Alexandr-Filatov/Three-Phase-80kWt/3D models/K78xxM-1000R3.stp

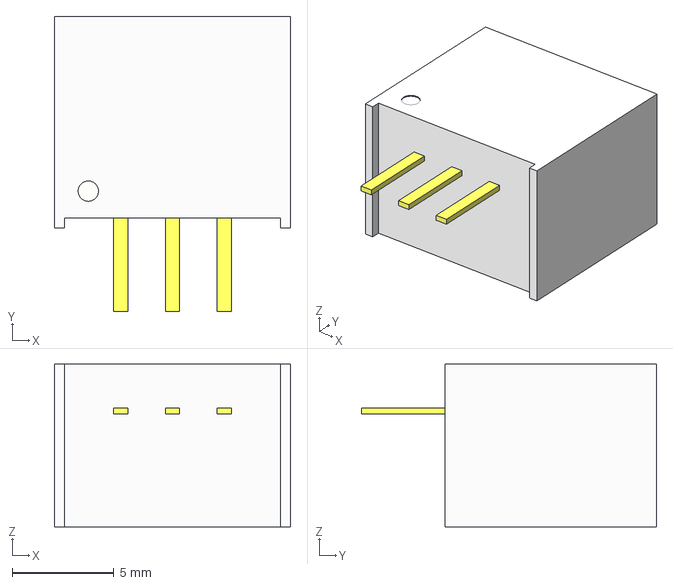
[picture p1: CAD file, 2024-10-06]
3D models/K78xxM-1000R3.stp
11.6 x 14.5 x 8.00 mm
