Alexandr-Filatov/Three-Phase-80kWt/3D models/Adapter.step

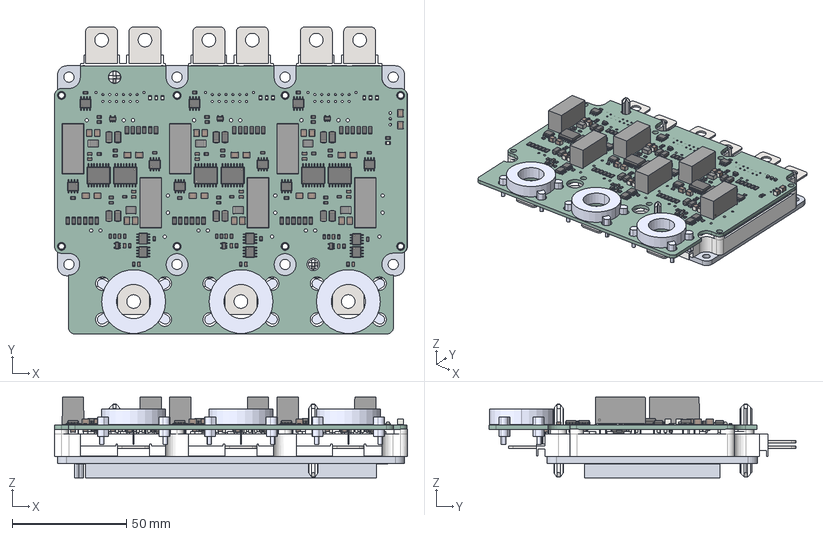
[picture p2: CAD file, 2024-10-06]
3D models/Adapter.step
154.6 x 134.5 x 35.2 mm
R_0805_2012Metric x 67
SOT_23_5 x 6
Current sensor low x 3
D_SMA x 12
C_1210_3225Metric x 26
R_1206_3216Metric x 36
C_0805_2012Metric x 63
WR_S-1WR2_ASM x 6
SOIC_8_39x49mm_P127mm x 15
LED_0805_2012Metric x 10
SOIC_16W_75x103mm_P127mm x 6
L_1812_4532Metric x 6
Starpower GD820HTX75P6HB
D_SOD_123 x 6
SOT_223 x 3
Adapter_PCB
