Alexandr-Filatov/Three-Phase-80kWt/3D models/Starpower GD820HTX75P6HB.STEP

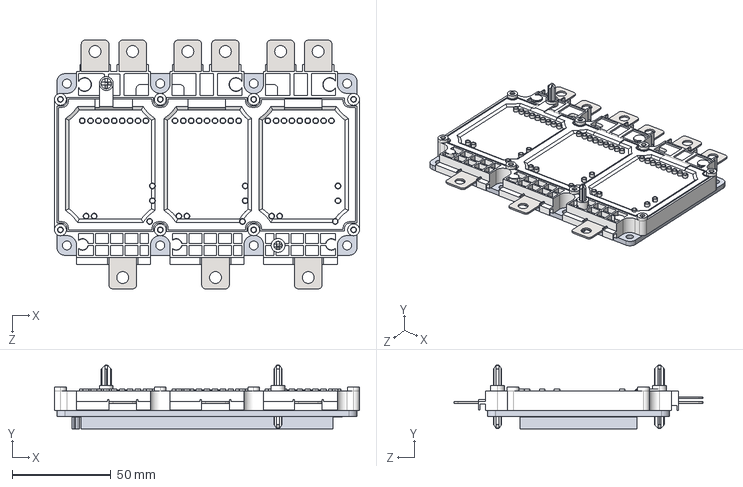
[picture p3: CAD file, 2024-10-06]
3D models/Starpower GD820HTX75P6HB.STEP
154.5 x 32.3 x 126.0 mm
