Alexandr-Filatov/Three-Phase-80kWt/3D models/K78xx-1000R3.stp

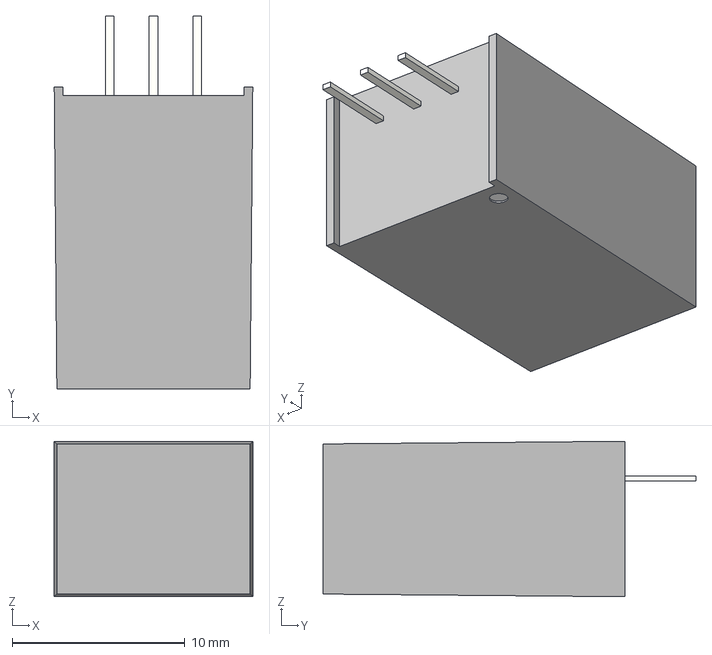
[picture p4: CAD file, 2024-09-23]
3D models/K78xx-1000R3.stp
11.5 x 21.6 x 9.00 mm
K78-1000_1
PRT0001_1 x 3
