Alexandr-Filatov/Three-Phase-80kWt/3D models/Current sensor low.STEP

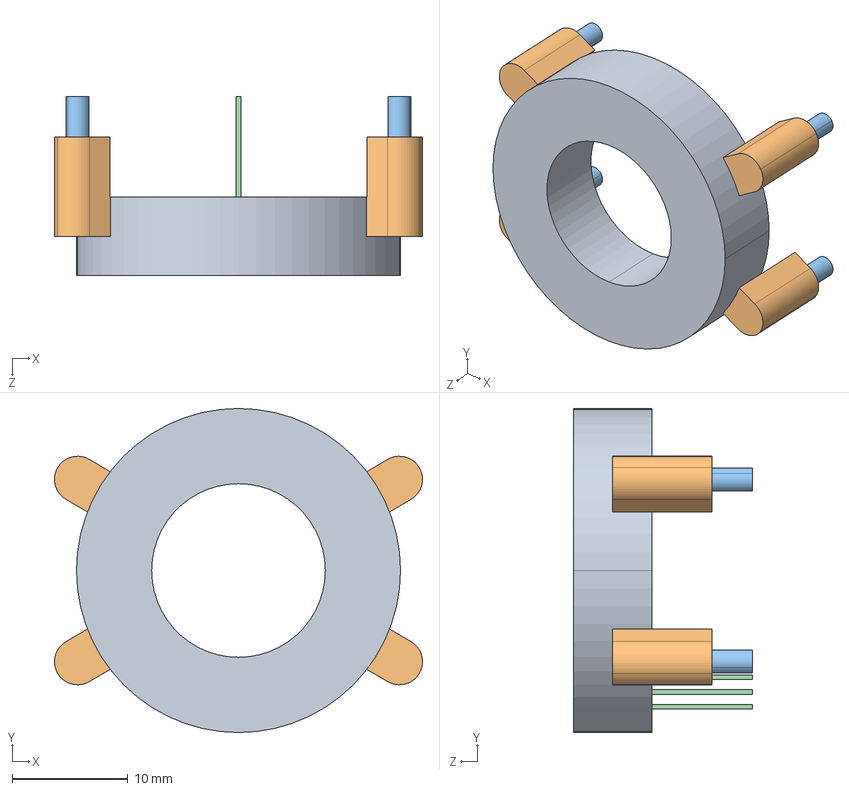
[picture p5: CAD file, 2024-09-12]
3D models/Current sensor low.STEP
31.8 x 28.0 x 15.5 mm
