Alexandr-Filatov/Three-Phase-80kWt/3D models/Current sensor.STEP

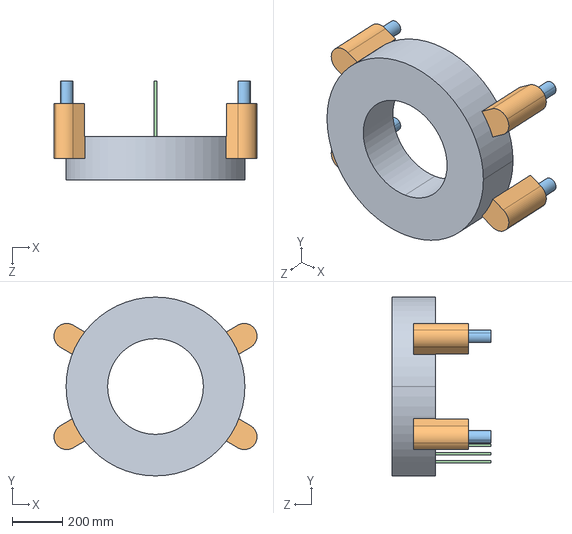
[picture p6: CAD file, 2024-09-12]
3D models/Current sensor.STEP
807.6 x 711.2 x 393.7 mm
