Alexandr-Filatov/Three-Phase-80kWt/3D models/WRA_S-3WR2.stp

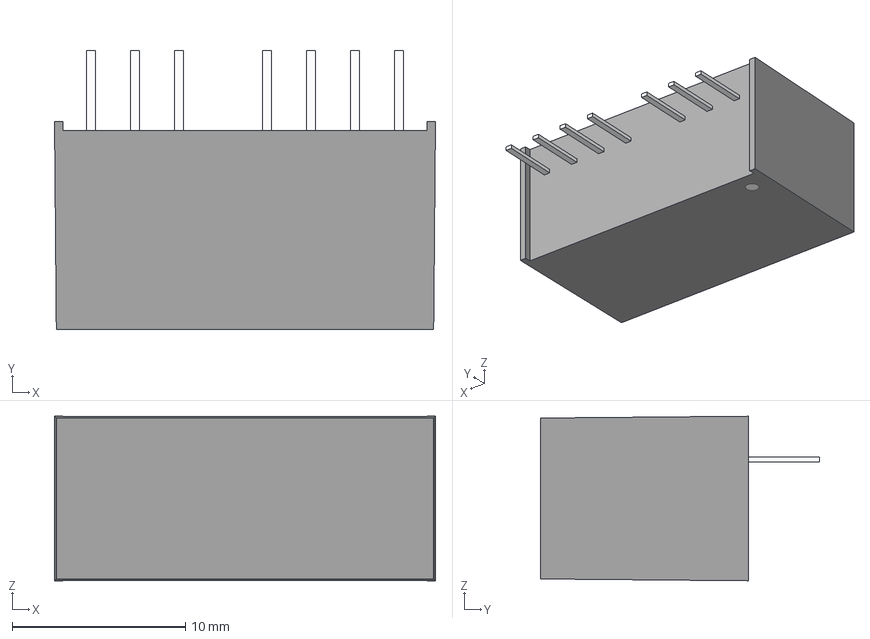
[picture p7: CAD file, 2024-09-02]
3D models/WRA_S-3WR2.stp
22.0 x 16.1 x 9.50 mm
PIN_3_1_1_1 x 7
