Alexandr-Filatov/Three-Phase-80kWt/3D models/URA_ZP-6WR3.stp

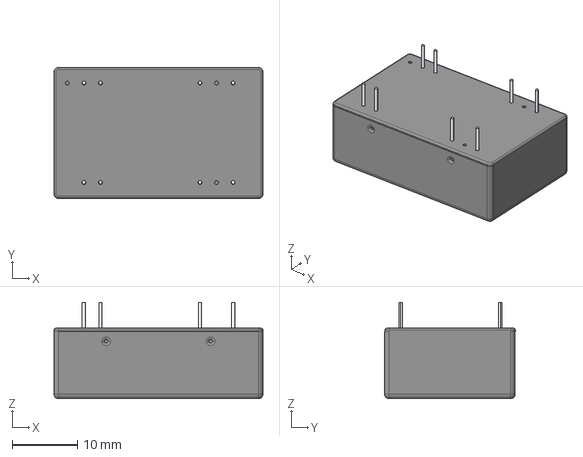
[picture p8: CAD file, 2024-09-02]
3D models/URA_ZP-6WR3.stp
32.0 x 20.1 x 14.8 mm
