Alexandr-Filatov/Three-Phase-80kWt/3D models/430251210.stp

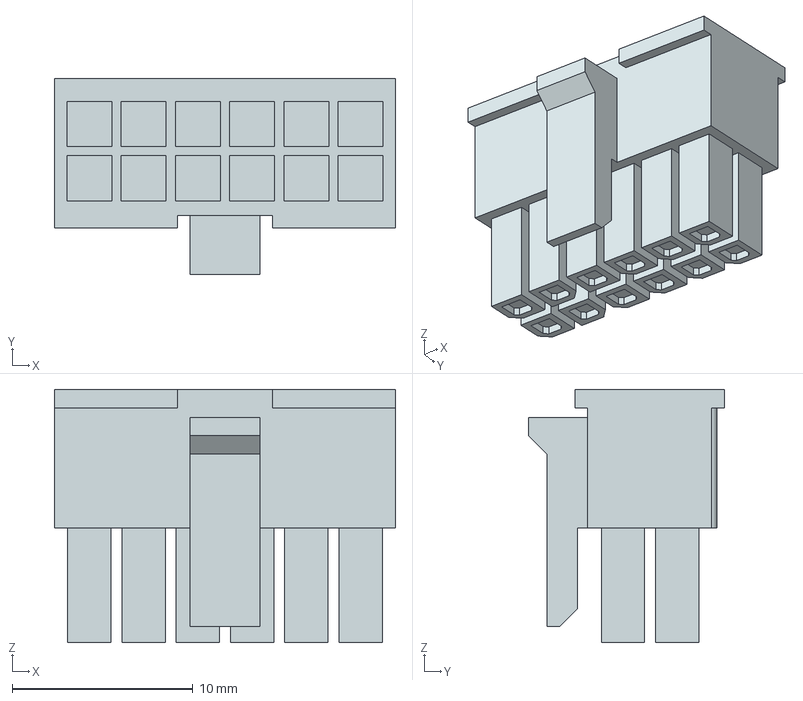
[picture p9: CAD file, 2024-11-12]
3D models/430251210.stp
18.9 x 10.8 x 14.0 mm
