Alexandr-Filatov/Three-Phase-80kWt/3D models/430451212.stp

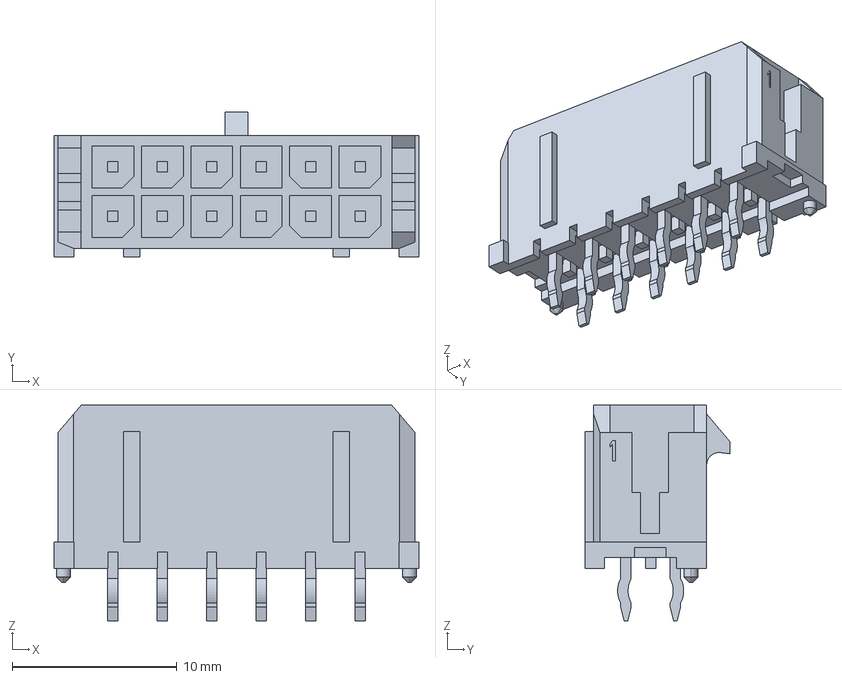
[picture p10: CAD file, 2024-09-26]
3D models/430451212.stp
22.1 x 8.77 x 13.1 mm
