Alexandr-Filatov/Three-Phase-80kWt/3D models/2068321222.stp

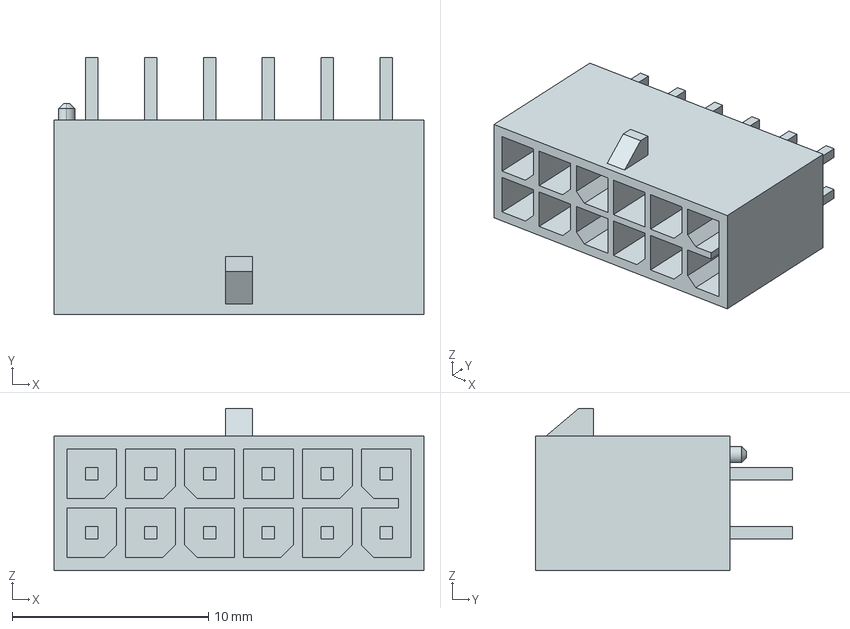
[picture p11: CAD file, 2024-09-26]
3D models/2068321222.stp
18.9 x 13.1 x 8.26 mm
