Alexandr-Filatov/Three-Phase-80kWt/(list of files, drawings)

Other design files:
K78xx-1000R3.SchLib
K78xxM-1000R3 正输出.SchLib
K78xxM-1000R3 负输出.PcbLib
K78xxM-1000R3 负输出.SchLib
K78xxM-1000R3.PcbLib
URA_ZP-6WR3.PcbLib
WRA_S-3WR2.PcbLib
