Alexandr-Filatov/Three-Phase-80kWt/Adapter.kicad_pcb

## KiCad design Adapter.kicad_pcb (2024-11-13)

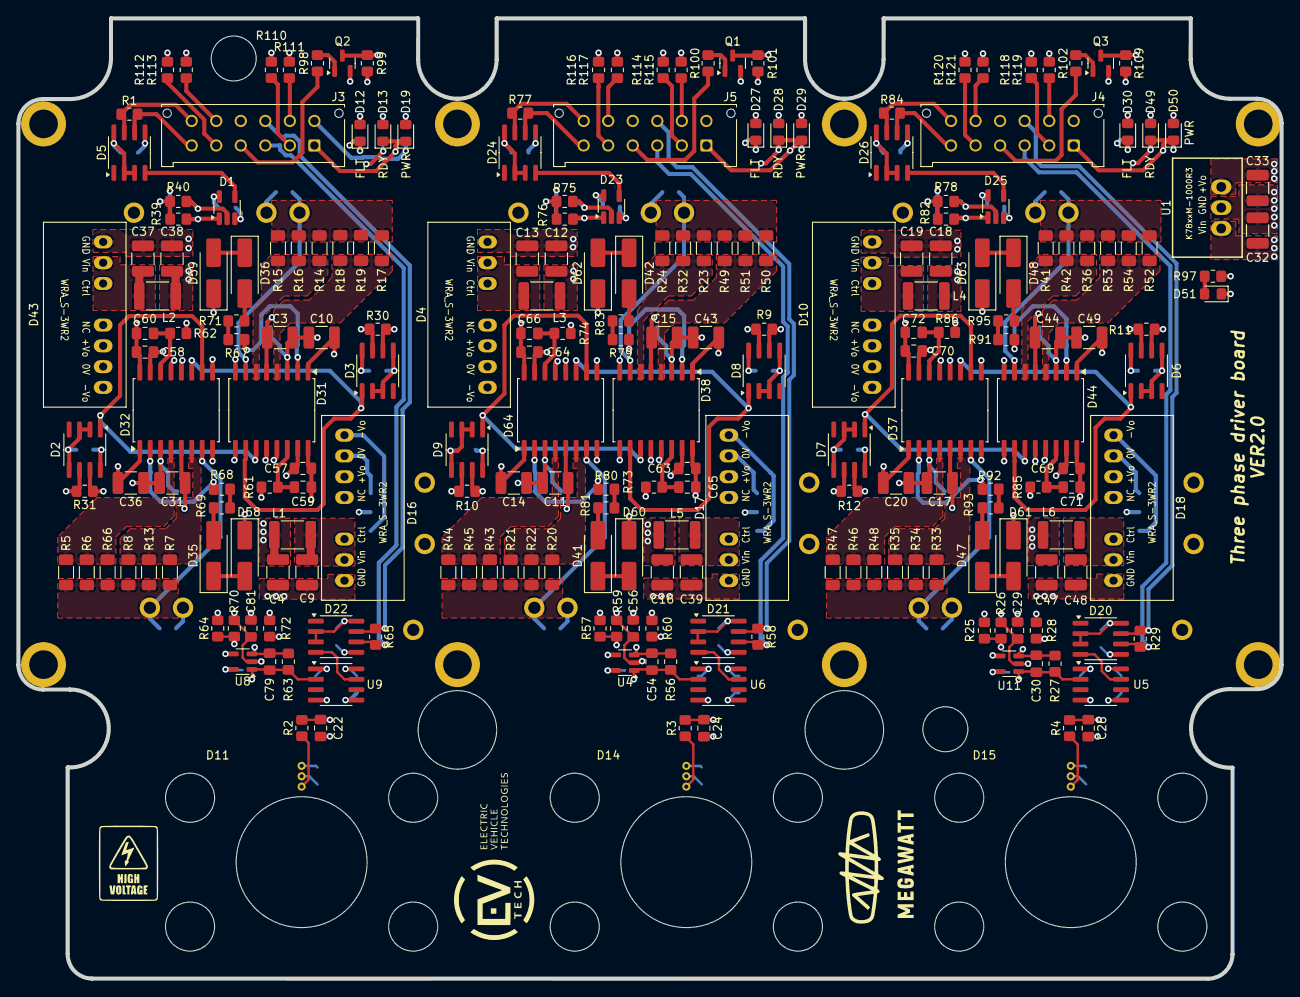
[picture p12: board Adapter.kicad_pcb from above]

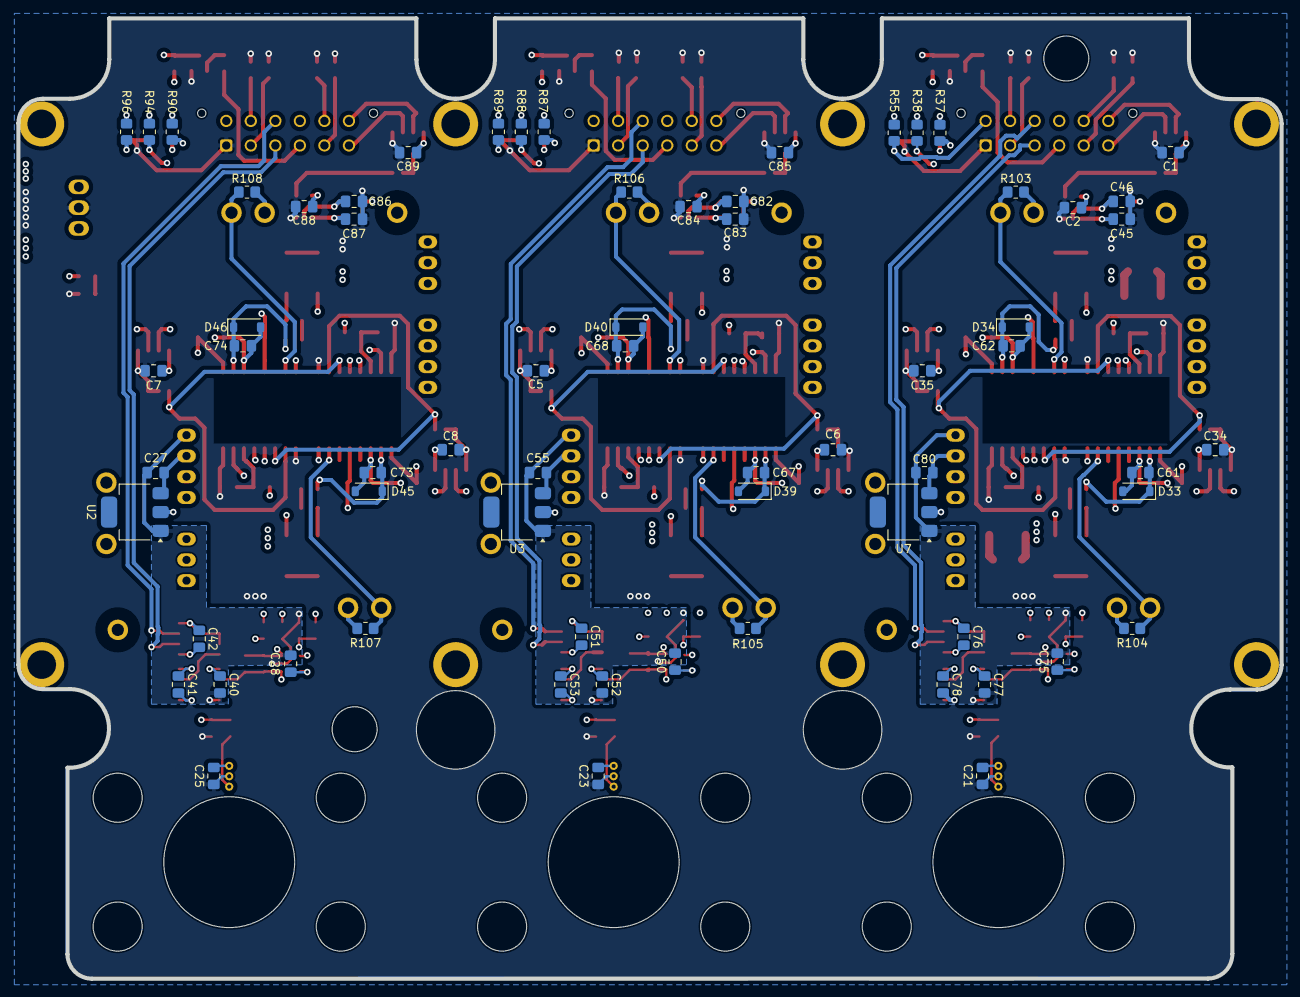
[picture p13: board Adapter.kicad_pcb from below]

Board: 6 copper layers, 154.4 x 117.4 mm, 291 parts (66 on the bottom side), 161 nets.

Parts:
C1, C2, C5, C6, C7, C8, C27, C28, C34, C35, C40, C41, C42, C50, C51, C52, C53, C55, C75, C76, C77, C78, C80, C84, C85, C88, C89: 2.2u; C_0805_2012Metric_Pad1.18x1.45mm_HandSolder
C3, C4, C9, C10, C11, C12, C13, C14, C15, C16, C17, C18, C19, C20, C31, C32, C36, C37, C38, C39, C43, C44, C47, C48, C49: 10u; C_1210_3225Metric_Pad1.33x2.70mm_HandSolder
C21, C23, C25, C57, C58, C63, C64, C69, C70: 0.1u; C_0805_2012Metric_Pad1.18x1.45mm_HandSolder
C22, C24, C26: 10u; C_0805_2012Metric_Pad1.18x1.45mm_HandSolder
C29, C56, C81: 10n; C_0805_2012Metric_Pad1.18x1.45mm_HandSolder
C30, C45, C46, C54, C59, C60, C65, C66, C71, C72, C79, C82, C83, C86, C87: 56p; C_0805_2012Metric_Pad1.18x1.45mm_HandSolder
C33: 22u; C_1210_3225Metric_Pad1.33x2.70mm_HandSolder
C61, C62, C67, C68, C73, C74: 220p; C_0805_2012Metric_Pad1.18x1.45mm_HandSolder
D1, D23, D25: SN74AHC1G08DBVR; SOT-23-5_HandSoldering
D2, D3, D5, D6, D7, D8, D9, D20, D21, D22, D24, D26: ADM3485E; SOIC-8_3.9x4.9mm_P1.27mm
D4, D10, D16, D17, D18, D43: WRA1215S-3WR2; WRA_S-3WR2
D11, D14, D15: YMC15S-500A
D12, D27, D30: FLT; LED_0805_2012Metric_Pad1.15x1.40mm_HandSolder
D13, D28, D49: RDY; LED_0805_2012Metric_Pad1.15x1.40mm_HandSolder
D19, D29, D50: PWR; LED_0805_2012Metric_Pad1.15x1.40mm_HandSolder
D31, D32, D37, D38, D44, D64: NSI6651ASC-DSWR; SOIC-16W_7.5x10.3mm_P1.27mm
D33, D34, D39, D40, D45, D46: MMSZ5240B; D_SOD-123
D35, D36, D41, D42, D47, D48, D58, D59, D60, D61, D62, D63: MURS160; D_SMA_Handsoldering
D51: +5V; LED_0805_2012Metric_Pad1.15x1.40mm_HandSolder
J1: GD820HTX75P6HB
J3: Control_A; Molex_Micro-Fit_3.0_43045-1212_2x06_P3.00mm_Vertical
J4: Control_C; Molex_Micro-Fit_3.0_43045-1212_2x06_P3.00mm_Vertical
J5: Control_B; Molex_Micro-Fit_3.0_43045-1212_2x06_P3.00mm_Vertical
L1, L2, L3, L4, L5, L6: 4.7u; L_1812_4532Metric_Pad1.30x3.40mm_HandSolder
Q1, Q2, Q3: BC817; SOT-23
R1, R9, R10, R11, R12, R29, R30, R31, R58, R61, R62, R65, R73, R74, R77, R84, R85, R86: 120; R_0805_2012Metric_Pad1.20x1.40mm_HandSolder
R2, R3, R4, R69, R71, R81, R83, R93, R95: 0; R_0805_2012Metric_Pad1.20x1.40mm_HandSolder
R5, R6, R7, R8, R13, R14, R15, R16, R17, R18, R19, R20, R21, R22, R23, R24, R32, R33, R34, R35, R36, R41, R42, R43, R44, R45, R46, R47, R48, R49, R50, R51, R52, R53, R54, R66: 10; R_1206_3216Metric_Pad1.30x1.75mm_HandSolder
R25, R26, R27, R56, R57, R59, R63, R64, R70, R103, R104, R105, R106, R107, R108: 10k; R_0805_2012Metric_Pad1.20x1.40mm_HandSolder
R28, R60, R72: 2.2k; R_0805_2012Metric_Pad1.20x1.40mm_HandSolder
R37, R38, R39, R40, R75, R76, R78, R82, R87, R88, R90, R94, R97, R99, R101, R109: 1k; R_0805_2012Metric_Pad1.20x1.40mm_HandSolder
R55, R89, R96: 3k; R_0805_2012Metric_Pad1.20x1.40mm_HandSolder
R67, R68, R79, R80, R91, R92: 1.1k; R_0805_2012Metric_Pad1.20x1.40mm_HandSolder
R98, R100, R102: 4.7k; R_0805_2012Metric_Pad1.20x1.40mm_HandSolder
R110, R111, R112, R113, R114, R115, R116, R117, R118, R119, R120, R121: 560; R_0805_2012Metric_Pad1.20x1.40mm_HandSolder
U1: K7805M-1000R3; K78xxM-1000R3
U2, U3, U7: LM1117GS-5.0; SOT-223
U4, U8, U11: LMV7219M5X/NOPB; SOT-23-5
U5, U6, U9: ADuM1200AR; SOIC-8_3.9x4.9mm_P1.27mm

Connections:
+5V: C1.1, C2.1, C5.1, C6.1, C7.1, C8.1, C21.1, C23.1, C25.1, C33.1, C34.1, C35.1, C41.1, C42.1, C51.1, C53.1, C57.2, C58.2, C63.2, C64.2, C69.2, C70.2, C76.1, C78.1, C84.1, C85.1, C88.1, C89.1, D1.5 (Vcc), D2.8 (VCC), D3.8 (VCC), D5.2 (RE), D5.3 (DE), D5.8 (VCC), D6.8 (VCC), D7.8 (VCC), D8.8 (VCC), D9.8 (VCC), D11.1 (+Vcc), D14.1 (+Vcc), D15.1 (+Vcc), D20.2 (RE), D20.3 (DE), D20.8 (VCC), D21.2 (RE), D21.3 (DE), D21.8 (VCC), D22.2 (RE), D22.3 (DE), D22.8 (VCC), D23.5 (Vcc), D24.2 (RE), D24.3 (DE), D24.8 (VCC), D25.5 (Vcc), D26.2 (RE), D26.3 (DE), D26.8 (VCC), D31.15 (Vcc1), D32.15 (Vcc1), D37.15 (Vcc1), D38.15 (Vcc1), D44.15 (Vcc1), D64.15 (Vcc1), R37.2, R39.2, R40.2, R75.2, R76.2, R78.2, R82.2, R87.2, R90.2, R97.2, R99.2, R101.2, R109.2, R111.2, R113.2, R115.2, R117.2, R119.2, R121.2, U1.3 (+Vo), U5.8 (VDD2), U6.8 (VDD2), U9.8 (VDD2)
+5V_A: C75.1, C77.1, R64.2, U7.2 (VO), U8.5 (V+), U9.1 (VDD1)
+5V_B: C50.1, C52.1, R57.2, U3.2 (VO), U4.5 (V+), U6.1 (VDD1)
+5V_C: C28.1, C40.1, R25.2, U2.2 (VO), U5.1 (VDD1), U11.5 (V+)
+15V: C4.1, C12.1, C16.1, C18.1, C32.1, C38.1, C47.1, J3.7, J4.7, J5.7, L1.1, L2.1, L3.1, L4.1, L5.1, L6.1, R55.2, R89.2, R96.2, U1.1 (Vin)
+15V_H1: C31.1, D32.5 (Vcc2), D43.6 (+Vo)
+15V_H2: C11.1, D4.6 (+Vo), D64.5 (Vcc2)
+15V_H3: C17.1, D10.6 (+Vo), D37.5 (Vcc2)
+15V_L1: C3.1, D16.6 (+Vo), D31.5 (Vcc2)
+15V_L2: C15.1, D17.6 (+Vo), D38.5 (Vcc2)
+15V_L3: C44.1, D18.6 (+Vo), D44.5 (Vcc2)
-15V_H1: C36.2, D32.1 (Vee2), D32.8 (Vee2), D43.8 (-Vo)
-15V_H2: C14.2, D4.8 (-Vo), D64.1 (Vee2), D64.8 (Vee2)
-15V_H3: C20.2, D10.8 (-Vo), D37.1 (Vee2), D37.8 (Vee2)
-15V_L1: C10.2, C75.2, C77.2, C80.2, C81.2, D16.8 (-Vo), D31.1 (Vee2), D31.8 (Vee2), R70.1, U7.1 (GND), U8.2 (V-), U9.4 (GND1)
-15V_L2: C43.2, C50.2, C52.2, C55.2, C56.2, D17.8 (-Vo), D38.1 (Vee2), D38.8 (Vee2), R59.1, U3.1 (GND), U4.2 (V-), U6.4 (GND1)
-15V_L3: C27.2, C28.2, C29.2, C40.2, C49.2, D18.8 (-Vo), D44.1 (Vee2), D44.8 (Vee2), R26.1, U2.1 (GND), U5.4 (GND1), U11.2 (V-)
C1: D58.1 (K), J1.1
C2: D59.1 (K), J1.2
C3: D60.1 (K), J1.9
C4: D62.1 (K), J1.10
C5: D61.1 (K), J1.17
C6: D63.1 (K), J1.18
Current_A_out: C22.1, J3.10, R2.2
Current_B_out: C24.1, J5.10, R3.2
Current_C_out: C26.1, J4.10, R4.2
E1: C31.2, C36.1, C61.2, D32.3 (GND2), D33.2 (A), D43.7 (0V), J1.3, R104.1
E2: C3.2, C10.1, C62.2, C80.1, D16.7 (0V), D31.3 (GND2), D34.2 (A), J1.4, R103.1, U7.3 (VI)
E3: C11.2, C14.1, C67.2, D4.7 (0V), D39.2 (A), D64.3 (GND2), J1.11, R105.1
E4: C15.2, C43.1, C55.1, C68.2, D17.7 (0V), D38.3 (GND2), D40.2 (A), J1.12, R106.1, U3.3 (VI)
E5: C17.2, C20.1, C73.2, D10.7 (0V), D37.3 (GND2), D45.2 (A), J1.19, R107.1
E6: C27.1, C44.2, C49.1, C74.2, D18.7 (0V), D44.3 (GND2), D46.2 (A), J1.20, R108.1, U2.3 (VI)
ERR_A_N: D5.7 (B), J3.12, R1.1
ERR_A_P: D5.6 (A), J3.6, R1.2
ERR_B_N: D24.7 (B), J5.12, R77.1
ERR_B_P: D24.6 (A), J5.6, R77.2
ERR_C_N: D26.7 (B), J4.12, R84.1
ERR_C_P: D26.6 (A), J4.6, R84.2
FLT_A: C45.1, D1.1 (B), D12.1 (K), D31.13 (~FLT), D32.13 (~FLT), R39.1
FLT_B: C83.1, D23.1 (B), D27.1 (K), D38.13 (~FLT), D64.13 (~FLT), R76.1
FLT_C: C87.1, D25.1 (B), D30.1 (K), D37.13 (~FLT), D44.13 (~FLT), R82.1
G1: D32.7 (CLAMP), J1.5, R5.1, R6.1, R7.2, R8.2, R13.2, R66.1, R104.2
G2: D31.7 (CLAMP), J1.6, R14.2, R15.2, R16.2, R17.1, R18.1, R19.1, R103.2
G3: D64.7 (CLAMP), J1.13, R20.2, R21.2, R22.2, R43.1, R44.1, R45.1, R105.2
G4: D38.7 (CLAMP), J1.14, R23.2, R24.2, R32.2, R49.1, R50.1, R51.1, R106.2
G5: D37.7 (CLAMP), J1.21, R33.2, R34.2, R35.2, R46.1, R47.1, R48.1, R107.2
G6: D44.7 (CLAMP), J1.22, R36.2, R41.2, R42.2, R52.1, R53.1, R54.1, R108.2
GND: C1.2, C2.2, C4.2, C5.2, C6.2, C7.2, C8.2, C9.2, C12.2, C13.2, C16.2, C18.2, C19.2, C21.2, C22.2, C23.2, C24.2, C25.2, C26.2, C32.2, C33.2, C34.2, C35.2, C37.2, C38.2, C39.2, C41.2, C42.2, C45.2, C46.2, C47.2, C48.2, C51.2, C53.2, C57.1, C58.1, C59.1, C60.1, C63.1, C64.1, C65.1, C66.1, C69.1, C70.1, C71.1, C72.1, C76.2, C78.2, C82.2, C83.2, C84.2, C85.2, C86.2, C87.2, C88.2, C89.2, D1.3 (GND), D2.2 (RE), D2.3 (DE), D2.5 (GND), D3.2 (RE), D3.3 (DE), D3.5 (GND), D4.1 (GND), D5.5 (GND), D6.2 (RE), D6.3 (DE), D6.5 (GND), D7.2 (RE), D7.3 (DE), D7.5 (GND), D8.2 (RE), D8.3 (DE), D8.5 (GND), D9.2 (RE), D9.3 (DE), D9.5 (GND), D10.1 (GND), D11.2 (0V), D13.1 (K), D14.2 (0V), D15.2 (0V), D16.1 (GND), D17.1 (GND), D18.1 (GND), D19.1 (K), D20.5 (GND), D21.5 (GND), D22.5 (GND), D23.3 (GND), D24.5 (GND), D25.3 (GND), D26.5 (GND), D28.1 (K), D29.1 (K), D31.9 (GND1), D31.16 (TEST), D32.9 (GND1), D32.16 (TEST), D37.9 (GND1), D37.16 (TEST), D38.9 (GND1), D38.16 (TEST), D43.1 (GND), D44.9 (GND1), D44.16 (TEST), D49.1 (K), D50.1 (K), D51.1 (K), D64.9 (GND1), D64.16 (TEST), J3.1, J4.1, J5.1, Q1.2 (E), Q2.2 (E), Q3.2 (E), R110.1, R112.1, R114.1, R116.1, R118.1, R120.1, U1.2 (GND), U5.5 (GND2), U6.5 (GND2), U9.5 (GND2)
unnamed: D1.4 (Y), D5.4 (DI)
unnamed: C13.1, D4.2 (Vin), L3.2
unnamed: C19.1, D10.2 (Vin), L4.2
unnamed: D11.3 (Output), R2.1
unnamed: D12.2 (A), R37.1
unnamed: D13.2 (A), R38.1
unnamed: D14.3 (Output), R3.1
unnamed: D15.3 (Output), R4.1
unnamed: C9.1, D16.2 (Vin), L1.2
unnamed: C39.1, D17.2 (Vin), L5.2
unnamed: C48.1, D18.2 (Vin), L6.2
unnamed: D19.2 (A), R55.1
unnamed: D20.4 (DI), U5.7 (VOA)
unnamed: D21.4 (DI), U6.7 (VOA)
unnamed: D22.4 (DI), U9.7 (VOA)
unnamed: D23.4 (Y), D24.4 (DI)
unnamed: D25.4 (Y), D26.4 (DI)
unnamed: D27.2 (A), R87.1
unnamed: D28.2 (A), R88.1
unnamed: D29.2 (A), R89.1
unnamed: D30.2 (A), R90.1
unnamed: C62.1, D31.2 (DESAT), D34.1 (K), R67.2
unnamed: D31.4 (OUTH), R17.2, R18.2, R19.2
unnamed: D31.6 (OUTL), R14.1, R15.1, R16.1
unnamed: C59.2, D31.14 (~RST), R61.2
unnamed: C61.1, D32.2 (DESAT), D33.1 (K), R68.2
unnamed: D32.4 (OUTH), R5.2, R6.2, R66.2
unnamed: D32.6 (OUTL), R7.1, R8.1, R13.1
unnamed: C60.2, D32.14 (~RST), R62.2
unnamed: D35.2 (A), R69.1
unnamed: D35.1 (K), D58.2 (A)
unnamed: D36.2 (A), R71.1
unnamed: D36.1 (K), D59.2 (A)
unnamed: C73.1, D37.2 (DESAT), D45.1 (K), R92.2
unnamed: D37.4 (OUTH), R46.2, R47.2, R48.2
unnamed: D37.6 (OUTL), R33.1, R34.1, R35.1
unnamed: C72.2, D37.14 (~RST), R86.2
unnamed: C68.1, D38.2 (DESAT), D40.1 (K), R79.2
unnamed: D38.4 (OUTH), R49.2, R50.2, R51.2
unnamed: D38.6 (OUTL), R23.1, R24.1, R32.1
unnamed: C65.2, D38.14 (~RST), R73.2
unnamed: C67.1, D39.1 (K), D64.2 (DESAT), R80.2
unnamed: D41.2 (A), R81.1
unnamed: D41.1 (K), D60.2 (A)
unnamed: D42.2 (A), R83.1
unnamed: D42.1 (K), D62.2 (A)
unnamed: C37.1, D43.2 (Vin), L2.2
unnamed: C74.1, D44.2 (DESAT), D46.1 (K), R91.2
unnamed: D44.4 (OUTH), R52.2, R53.2, R54.2
unnamed: D44.6 (OUTL), R36.1, R41.1, R42.1
unnamed: C71.2, D44.14 (~RST), R85.2
unnamed: D47.2 (A), R93.1
unnamed: D47.1 (K), D61.2 (A)
unnamed: D48.2 (A), R95.1
unnamed: D48.1 (K), D63.2 (A)
unnamed: D49.2 (A), R94.1
unnamed: D50.2 (A), R96.1
unnamed: D51.2 (A), R97.1
unnamed: D64.4 (OUTH), R43.2, R44.2, R45.2
unnamed: D64.6 (OUTL), R20.1, R21.1, R22.1
unnamed: C66.2, D64.14 (~RST), R74.2
unnamed: Q1.1 (B), R100.2
unnamed: Q2.1 (B), R98.2
unnamed: Q3.1 (B), R102.2
unnamed: R67.1, R71.2
unnamed: R68.1, R69.2
unnamed: R79.1, R83.2
unnamed: R80.1, R81.2
unnamed: R91.1, R95.2
unnamed: R92.1, R93.2
unnamed: C54.1, R56.1, R57.1, R59.2, U4.3 (+)
unnamed: C30.2, R27.2, R28.1, U5.2 (VIA), U11.1
unnamed: C54.2, R56.2, R60.1, U4.1, U6.2 (VIA)
unnamed: C79.1, R63.1, R64.1, R70.2, U8.3 (+)
unnamed: C79.2, R63.2, R72.1, U8.1, U9.2 (VIA)
unnamed: C30.1, R25.1, R26.2, R27.1, U11.3 (+)
PWM1_H_N: D2.7 (B), J3.5, R31.1, R112.2
PWM1_H_P: D2.6 (A), J3.11, R31.2, R113.1
PWM1_L_N: D3.7 (B), J3.2, R30.1, R110.2
PWM1_L_P: D3.6 (A), J3.8, R30.2, R111.1
PWM2_H_N: D9.7 (B), J5.5, R10.1, R116.2
PWM2_H_P: D9.6 (A), J5.11, R10.2, R117.1
PWM2_L_N: D8.7 (B), J5.2, R9.1, R114.2
PWM2_L_P: D8.6 (A), J5.8, R9.2, R115.1
PWM3_H_N: D7.7 (B), J4.5, R12.1, R120.2
PWM3_H_P: D7.6 (A), J4.11, R12.2, R121.1
PWM3_L_N: D6.7 (B), J4.2, R11.1, R118.2
PWM3_L_P: D6.6 (A), J4.8, R11.2, R119.1
PWM_H1: D2.1 (RO), D31.11 (IN-), D32.10 (IN+)
PWM_H2: D9.1 (RO), D38.11 (IN-), D64.10 (IN+)
PWM_H3: D7.1 (RO), D37.10 (IN+), D44.11 (IN-)
PWM_L1: D3.1 (RO), D31.10 (IN+), D32.11 (IN-)
PWM_L2: D8.1 (RO), D38.10 (IN+), D64.11 (IN-)
PWM_L3: D6.1 (RO), D37.11 (IN-), D44.10 (IN+)
RDY_A: C46.1, D1.2 (A), D31.12 (RDY), D32.12 (RDY), R38.2, R40.1
RDY_B: C82.1, D23.2 (A), D38.12 (RDY), D64.12 (RDY), R75.1, R88.2
RDY_C: C86.1, D25.2 (A), D37.12 (RDY), D44.12 (RDY), R78.1, R94.2
T1: C81.1, J1.7, U8.4 (-)
T2: J1.8, R72.2
T3: C56.1, J1.15, U4.4 (-)
T4: J1.16, R60.2
T5: C29.1, J1.23, U11.4 (-)
T6: J1.24, R28.2
Temp_A_N: D22.7 (B), J3.9, R65.1
Temp_A_P: D22.6 (A), J3.3, R65.2
Temp_B_N: D21.7 (B), J5.9, R58.1
Temp_B_P: D21.6 (A), J5.3, R58.2
Temp_C_N: D20.7 (B), J4.9, R29.1
Temp_C_P: D20.6 (A), J4.3, R29.2
~RST_A: Q2.3 (C), R61.1, R62.1, R99.1
~RST_B: Q1.3 (C), R73.1, R74.1, R101.1
~RST_C: Q3.3 (C), R85.1, R86.1, R109.1
~RST: J3.4, J4.4, J5.4, R98.1, R100.1, R102.1
