Alexandr-Filatov/Three-Phase-80kWt/(commit log)

2023-10-03 Тестовая версия
    [Adapter-B_Cu.gbr, Adapter-B_Mask.gbr, Adapter-B_Paste.gbr, Adapter-B_Silkscreen.gbr, Adapter-Edge_Cuts.gbr, Adapter-F_Cu.gbr, Adapter-F_Mask.gbr, Adapter-F_Paste.gbr]
2024-01-16 Поменял компаратор на пушпульный
    [Adapter.kicad_sch, Common_ERR.kicad_sch, Connectors.kicad_sch, Driver_1.kicad_sch, Driver_2.kicad_sch, Driver_3.kicad_sch, Fault1.kicad_sch, Fault2.kicad_sch]
2024-01-16 Поменял драйвера на китайские
    [Adapter.kicad_pcb, Driver_1.kicad_sch, Driver_2.kicad_sch, Driver_3.kicad_sch]
2024-09-02 Изменил схему
    [Adapter.kicad_pcb, Adapter.kicad_sch, Common_ERR.kicad_sch, Connectors.kicad_sch, Driver_1.kicad_sch, Driver_2.kicad_sch, Driver_3.kicad_sch, Fault1.kicad_sch]
2024-09-05 Разместил все три стойки в своей области
    [Adapter 3PH-1-1(Для Саши).DXF, Adapter.kicad_pcb, Adapter.kicad_sch, Connectors.kicad_sch, Current_Sensors.kicad_sch, Driver_1.kicad_sch, Driver_2.kicad_sch, Driver_3.kicad_sch]
2024-09-12 Добавил температурные контуры звщиты
    [Adapter.kicad_pcb, Adapter.kicad_sch, Current sensor low.STEP, Current sensor.STEP, Current_Sensors.kicad_sch, Fault1.kicad_sch, NTC1_Block.kicad_sch, NTC1_Block_A.kicad_sch]
2024-09-17 Убрал питание 3.3В
    [Adapter.kicad_pcb, Adapter.kicad_sch, Driver_1.kicad_sch, Driver_2.kicad_sch, Driver_3.kicad_sch, Fault1.kicad_sch, Logic_Pritection.kicad_sch, Logic_Protection2.kicad_sch]
2024-09-23 Развел стойку фазы А
    [Adapter.kicad_pcb, Adapter.kicad_sch, Driver_1.kicad_sch, Driver_2.kicad_sch, Driver_3.kicad_sch, Fault1.kicad_sch, K78xx-1000R3.SchLib, K78xx-1000R3.stp]
2024-09-25 Начал разводить вторую стойку
    [Adapter.kicad_pcb, Driver_2.kicad_sch, Power_Supply_2.kicad_sch]
2024-09-26 Добавил новые разъёмы
    [2068321222.stp, 430451212.stp, Adapter.kicad_pcb, Adapter.step, Connectors.kicad_sch, NTC_Handler.kicad_sch]
2024-10-03 Развел вторую стойку
    [Adapter.kicad_pcb, Connectors.kicad_sch, Driver_1.kicad_sch, Driver_2.kicad_sch, Driver_3.kicad_sch, Fault1.kicad_sch, NTC_Handler.kicad_sch]
2024-10-06 Развел все
    [Adapter.step, Connectors.kicad_sch, Current_Sensors.kicad_sch, Driver_1.kicad_sch, Driver_2.kicad_sch, Driver_3.kicad_sch, Fault1.kicad_sch, K78xxM-1000R3 正输出.PcbLib]
2024-10-23 Отправил на проверку в резонит: изменил BOM
    [Adapter 3PH-1-1(Для Саши).DXF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]
2024-10-24 Изменения: обновил BOM и названия в схеме
    [BOM_Three_Phase_Driver_VER2.0.xlsx, Driver_1.kicad_sch, Driver_2.kicad_sch, Driver_3.kicad_sch, NTC_Handler.kicad_sch, Power_Supply_1.kicad_sch, Power_Supply_2.kicad_sch, Power_Supply_3.kicad_sch]
2024-10-24 Изменения: в BOM добавил столбец наличия компонентов
    [BOM_Three_Phase_Driver_VER2.0.xlsx]
2024-11-12 Исправления: исправил нумерацию ножек датчиков тока
    [Adapter.kicad_pcb, Connectors.kicad_sch, Current_Sensors.kicad_sch, Driver_1.kicad_sch, Driver_2.kicad_sch, Driver_3.kicad_sch, Fault1.kicad_sch, Logic_Pritection.kicad_sch]
2024-11-12 Исправления: исправил номиналы подтяжек и сопротивления светодиодов
    [Fault1.kicad_sch, SupplyPower_5V.kicad_sch]
2024-11-12 Исправления: заменил полевые на биполярные в контуре RESET и изменил номиналы резисторов базы, исправил BOM
    [430251210.stp, Adapter.kicad_pcb, BOM_Three_Phase_Driver_VER2.0.xlsx, Connectors.kicad_sch, SupplyPower_5V.kicad_sch]
2024-11-13 Изменения: добавил подтяжки шины RS485
    [Adapter-B_Cu.gbr, Adapter-B_Mask.gbr, Adapter-B_Paste.gbp, Adapter-B_Paste.gbr, Adapter-B_Silks.gbr, Adapter-B_Silkscreen.gbr, Adapter-Edge_Cuts.gbr, Adapter-Edge_Cuts.gm1]
2024-11-17 VER2.0: отпаравил файлы в китай, обновил BOM
    [Adapter-B_Cu.gbr, Adapter-B_Mask.gbr, Adapter-B_Paste.gbp, Adapter-B_Paste.gbr, Adapter-B_Silks.gbr, Adapter-Edge_Cuts.gbr, Adapter-Edge_Cuts.gm1, Adapter-F_Cu.gbr]
2024-11-19 Изменения: изменил BOM, сделал заказ
    [BOM_Three_Phase_Driver_VER2.0_for_production.xls]
2024-11-27 Изменения: добавил папку Docs
